Shrey9378/Adjustable-Manipulator-Design/(list of files, cad)

Other CAD files:
assembly_files/Assembly4.iam
